Farmers-Data-Lab/Cover-Crop-Micro-Environment-Sensor-Bar/sensor_documentation/RWE102210-02-BOM.xls

 |  |  |  |  |  | AutoQuoterX II Bill of Materials
 |  |  |  |  |  |  |  |  |  |  |  |  |  | 1
 |  |  |  |  |  |  |  |  | # of Kits:
 |  |  |  |  |  |  |  |  | Req. Del. Date: |  |  |  |  | Friday, June 14, 2024
 |  |  |  |  |  |  |  |  | Distributor PO:
 |  |  |  |  |  |  |  |  | Customer PO:
 |  |  |  |  |  |  |  |  | Customer Ref:
 |  |  | Distributor: |  |  |  |  |  |  |  |  |  |  |  |  |  | Customer:
Ralph W. Earl Co. |  |  |  |  |  |  |  |  |  |  |  |  |  |  | Cornell University
 |  |  |  |  |  |  |  |  |  |  |  |  |  |  | RWE102210-02
, |  |  |  |  |  |  |  |  |  |  |  |  |  |  | ,
Contact #1: |  |  |  |  |  |  |  |  |  |  |  |  |  |  | Contact #1:
Email: |  |  |  |  |  |  |  |  |  |  |  |  |  |  | Email:
Contact #2: |  |  |  |  |  |  |  |  |  |  |  |  |  |  | Contact #2:
Email: |  |  |  |  |  |  |  |  |  |  |  |  |  |  | Email:
Company Email: |  |  |  |  |  |  |  |  |  |  |  |  |  |  | Company Email:
 |  |  |  |  |  |  |  | Notes: |  |  |  | Bill Of Materials creates 1 kits.
Tag |  | Part # |  | Qty | Length Each (or area) |  |  |  |  | Units | Total Wgt(lbs) |  | Description Note:all extrusion dimensions start at the left end
A |  | 1010 |  | 1 | 60.000 |  |  |  |  | IN | 2.61 |  | 7061 Left; 7061 Right
B |  | 1010 |  | 1 | 48.000 |  |  |  |  | IN | 2.09 |  | 7061 Left; 7061 Right
C |  | 1010 |  | 1 | 6.000 |  |  |  |  | IN | 0.26 |  | 7061 Right; 7042 in B Left; 7042 in D Left
D |  | 1010 |  | 1 | 6.000 |  |  |  |  | IN | 0.26 |  | 1" X 1" T-SLOTTED EXTRUSION
E |  | 1050 |  | 1 | 19.000 |  |  |  |  | IN | 0.61 |  | 1" X .5" T-SLOTTED EXTRUSION
 |  | 7005 |  | 5 |  |  |  |  |  | EA | 0.00 |  | Cut to Length 1" x 1" T-Slot and Tube
 |  | 7042 |  | 2 |  |  |  |  |  | EA | 0.00 |  | Anchor Fastener Counterbore for 10S
 |  | 7061 |  | 5 |  |  |  |  |  | EA | 0.00 |  | 1/4-20 Tap For 1" x 1" Extrusions
F |  | 2015 |  | 5 |  |  |  |  |  | EA | 0.02 |  | 1010 END CAP BLACK W/PUSH-INS
G |  | 4115 |  | 1 |  |  |  |  |  | EA | 0.06 |  | 10 S 4 HOLE INSIDE CORNER BRACKET
H |  | 4119 |  | 1 |  |  |  |  |  | EA | 0.03 |  | 10 S 2 HOLE INSIDE CORNER BRACKET
I |  | 6760 |  | 4 |  |  |  |  |  | EA | 0.72 |  | 10 S SINGLE SHORT UNIBEARING
J |  | 6850 |  | 1 |  |  |  |  |  | EA | 0.05 |  | 10 S L-HANDLE LINEAR BRAKE
K |  | 7412 |  | 1 |  |  |  |  |  | EA | 0.00 |  | YOUR ORDER IS DIVIDED INTO KITFORM AT NO EXTRA CHARGE
L |  | 7413 |  | 1 |  |  |  |  |  | EA | 0.00 |  | YOUR ORDER IS TAGGED PER YOUR BOM AT NO EXTRA CHARGE
 |  | 3276 |  | 12 |  |  |  |  |  | EA | 0.10 |  | 10 S ECON T-NUT 10-32 THREAD
 |  | 3382 |  | 12 |  |  |  |  |  | EA | 0.11 |  | 10 S ECON T-NUT 1/4-20 THREAD
 |  | 3393 |  | 6 |  |  |  |  |  | EA | 0.10 |  | 1/4-20 X 1/2" BHSCS, ECON T-NUT
 |  | 3395 |  | 2 |  |  |  |  |  | EA | 0.06 |  | 10 S ANCHOR FASTENER ASSEMBLY
 | Total weight for 1 kits: |  |  |  |  |  | 7.08
 |  |  |  |  |  |  |  |  |  |  |  |  |  |  |  | Total amount for 1 kits:
Drawing Filename: Y:\ARCHIVE\CORNELL UNIV\RWE102210\RWE102210-02.dwg
AutoQuoterX II Version-D19: 2.10.46.31
Price release date: 9/11/2023 Prices subject to change without notice.
