Farmers-Data-Lab/Cover-Crop-Micro-Environment-Sensor-Bar/Parts_links.txt

https://github.com/Farmers-Data-Lab/Cover-Crop-Micro-Environment-Sensor-Bar

https://www.amazon.com/dp/B0BGQ8C3XD?psc=1&ref=ppx_yo2ov_dt_b_product_details

https://www.amazon.com/dp/B07C4KQLPD?psc=1&ref=ppx_yo2ov_dt_b_product_details

https://www.amazon.com/dp/B0CXPBRJZM?psc=1&ref=ppx_yo2ov_dt_b_product_details

https://www.amazon.com/dp/B0B2PHX7V3?psc=1&ref=ppx_yo2ov_dt_b_product_details

https://www.amazon.com/dp/B0D14RMBDM?psc=1&ref=ppx_yo2ov_dt_b_product_details

https://www.amazon.com/dp/B078ZWDR8P?psc=1&ref=ppx_yo2ov_dt_b_product_details

https://www.amazon.com/dp/B0C2TY6QZZ?psc=1&ref=ppx_yo2ov_dt_b_product_details

https://www.amazon.com/dp/B07H5G7GC6?psc=1&ref=ppx_yo2ov_dt_b_product_details

https://www.amazon.com/dp/B093PWRJS9?psc=1&ref=ppx_yo2ov_dt_b_product_details

https://www.amazon.com/dp/B0BY8SHQZS?psc=1&ref=ppx_yo2ov_dt_b_product_details

https://www.amazon.com/dp/B07TGJGJGD?psc=1&ref=ppx_yo2ov_dt_b_product_details

https://www.amazon.com/dp/B0B2NWK1QX?psc=1&ref=ppx_yo2ov_dt_b_product_details

https://www.amazon.com/dp/B084DM42JS?psc=1&ref=ppx_yo2ov_dt_b_product_details

https://www.amazon.com/dp/B09WZY8CFV?psc=1&ref=ppx_yo2ov_dt_b_product_details

https://www.amazon.com/dp/B07ZV8FWM4?psc=1&ref=ppx_yo2ov_dt_b_product_details

https://www.amazon.com/dp/B08XVMBR6P?psc=1&ref=ppx_yo2ov_dt_b_product_details

https://www.amazon.com/dp/B0CSJXL3PV?psc=1&ref=ppx_yo2ov_dt_b_product_details

https://www.amazon.com/dp/B07WQJ2GD6?psc=1&ref=ppx_yo2ov_dt_b_product_details

https://www.amazon.com/dp/B0B9XT9HM8?psc=1&ref=ppx_yo2ov_dt_b_product_details

https://www.amazon.com/dp/B00LZVEQEY?psc=1&ref=ppx_yo2ov_dt_b_product_details

https://www.amazon.com/dp/B003CU3E2Q?psc=1&ref=product_details

https://www.amazon.com/dp/B0B973QQ8P?psc=1&ref=product_details

https://www.amazon.com/dp/B09KTCQT8Q?psc=1&ref=product_details

https://www.amazon.com/dp/B07RVG34WR?psc=1&ref=product_details

https://www.amazon.com/dp/B0C4JVVXTN?psc=1&ref=product_details

https://www.amazon.com/dp/B09DPGRQ98?psc=1&ref=product_details

https://www.amazon.com/dp/B0CPY6FM4B?psc=1&ref=product_details

https://www.amazon.com/dp/B09SXKSK41?psc=1&ref=product_details

https://www.amazon.com/dp/B0C89K5738?psc=1&ref=product_details

https://www.amazon.com/dp/B0C7YG99FC?psc=1&ref=product_details

https://www.amazon.com/dp/B08TW2P5LD?psc=1&ref=product_details

https://www.amazon.com/dp/B0CNNPJQN5?psc=1&ref=product_details

https://www.amazon.com/dp/B0046AMGW0?psc=1&ref=product_details

https://www.amazon.com/dp/B09VGK59XQ?psc=1&ref=product_details

https://www.amazon.com/dp/B0BCL27ZS3?psc=1&ref=product_details

https://www.adafruit.com/product/1141

https://www.adafruit.com/product/1440

https://www.adafruit.com/product/1439

https://www.adafruit.com/product/3127

https://www.adafruit.com/product/1536

https://www.adafruit.com/product/1294

https://www.adafruit.com/product/5382

https://www.adafruit.com/product/1947

https://www.fastenal.com/product/details/0154600#
