Farmers-Data-Lab/Cover-Crop-Micro-Environment-Sensor-Bar/sensor_documentation/RWE102210-02-Assy Ref Model[31].pdf

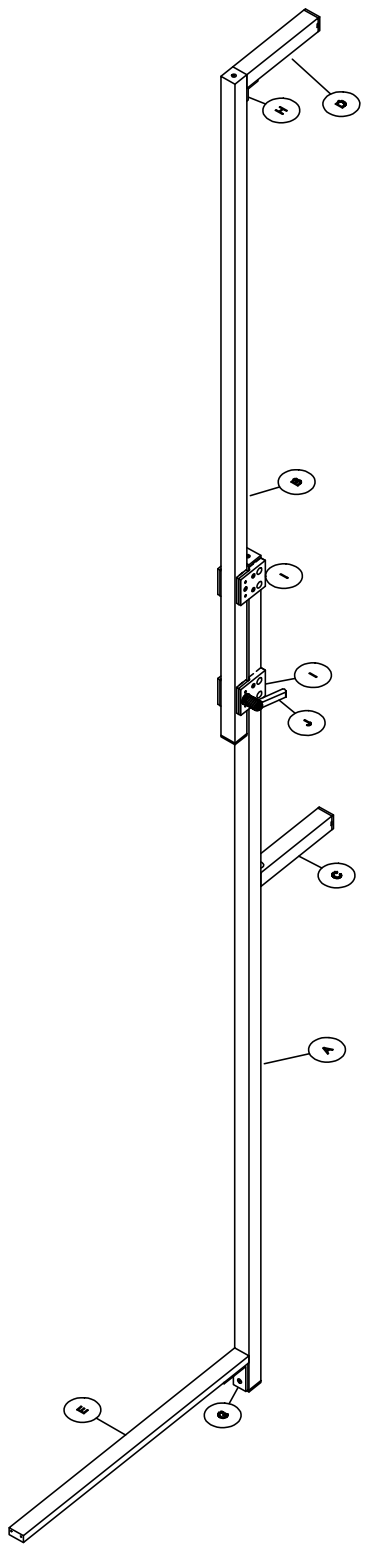
[picture p1: page 1]
